Oswald4422/veridis_app/Resources/IMG_5438.JPG.jpeg

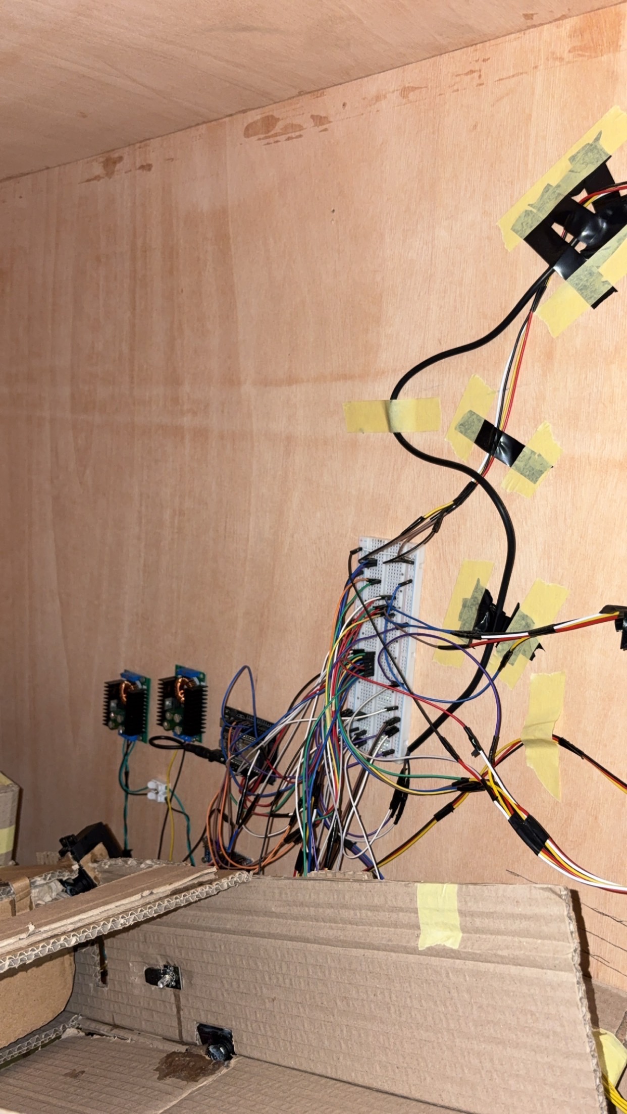
Resources/IMG_5438.JPG.jpeg
