Oswald4422/veridis_app/Resources/IMG_5457.JPG.jpeg

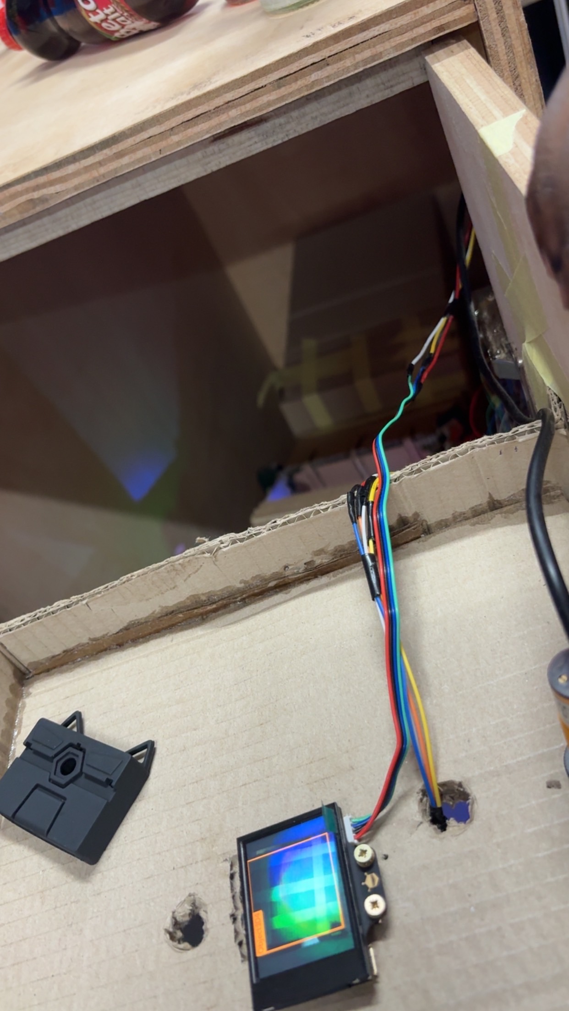
Resources/IMG_5457.JPG.jpeg
