Oswald4422/veridis_app/Resources/IMG_5458.JPG.jpeg

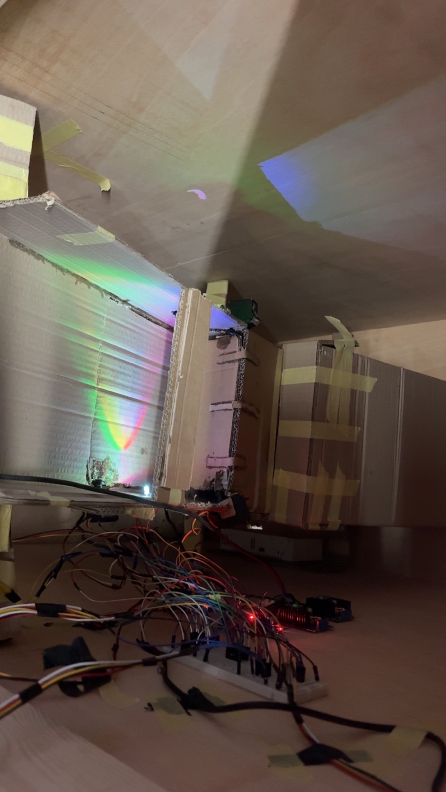
Resources/IMG_5458.JPG.jpeg
