Oswald4422/veridis_app/Resources/PNG image 2.png

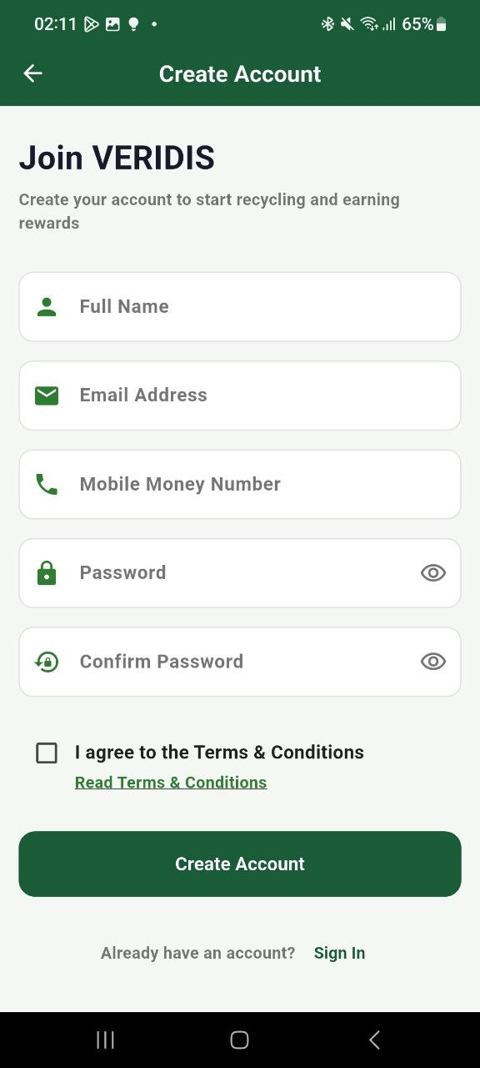
Resources/PNG image 2.png
