Oswald4422/veridis_app/Resources/PNG image 3.png

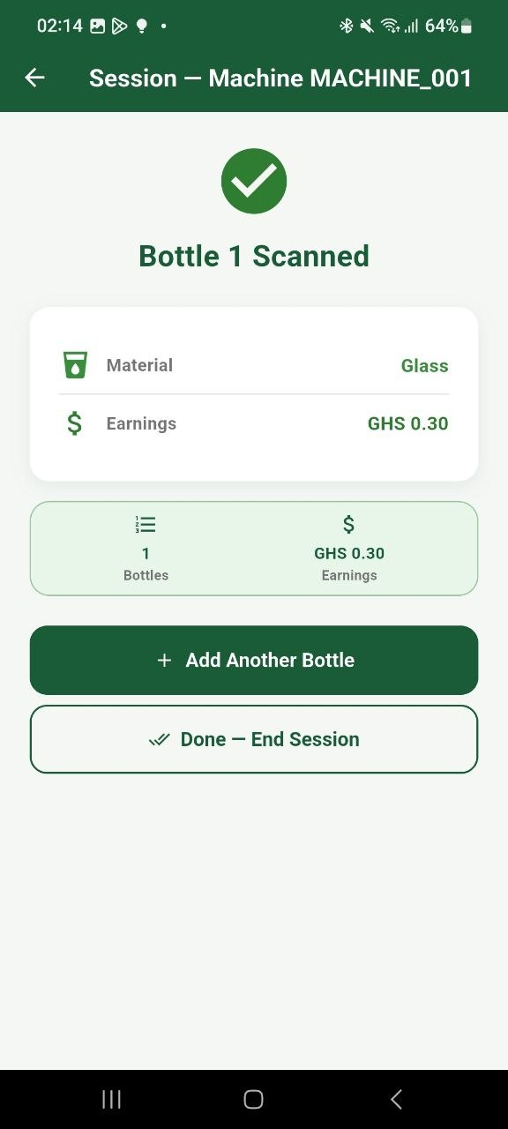
Resources/PNG image 3.png
