Oswald4422/veridis_app/Resources/PNG image.png

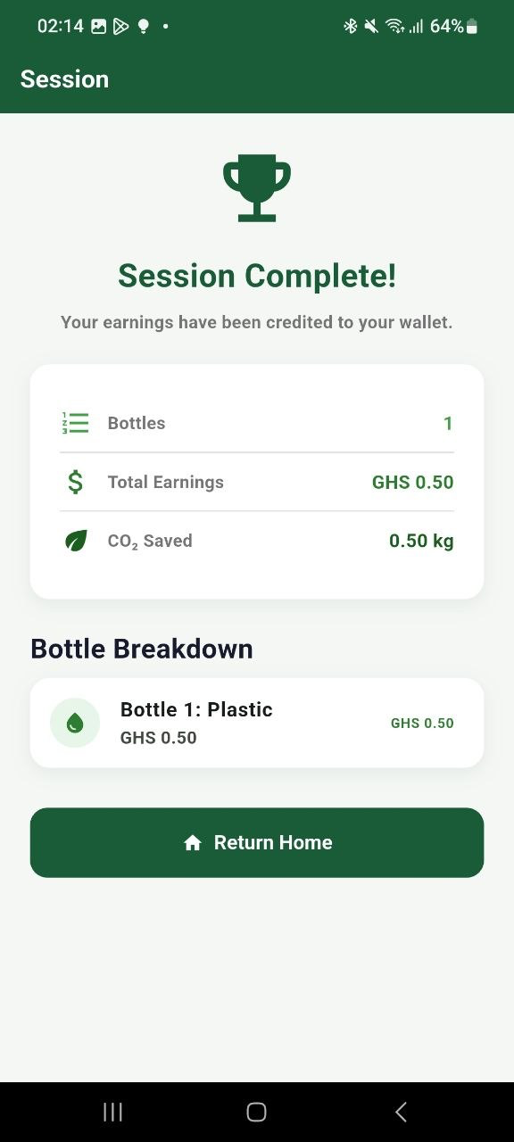
Resources/PNG image.png
