Oswald4422/veridis_app/state_machine/Screen_test/Screen_test.ino

#include "SPI.h"
#include "Adafruit_GFX.h"
#include "Adafruit_ILI9341.h"

// Define the pins based on your wiring
#define TFT_DC 17
#define TFT_CS 5
#define TFT_RST 16

// Initialize the display using Hardware SPI
Adafruit_ILI9341 tft = Adafruit_ILI9341(TFT_CS, TFT_DC, TFT_RST);

void setup() {
  tft.begin();
  tft.setRotation(1); // Set landscape or portrait
  tft.fillScreen(ILI9341_BLACK);
  tft.setCursor(0, 0);
  tft.setTextColor(ILI9341_WHITE);
  tft.setTextSize(2);
  tft.println("Hello World!");
}

void loop() {}
